AmeliaEScott/BLESoilMoistureSensors/SoilSensorHardware/nrf51x22_qfax_dcdc.kicad_pcb

## KiCad design SoilSensorHardware/nrf51x22_qfax_dcdc.kicad_pcb (2023-07-12)

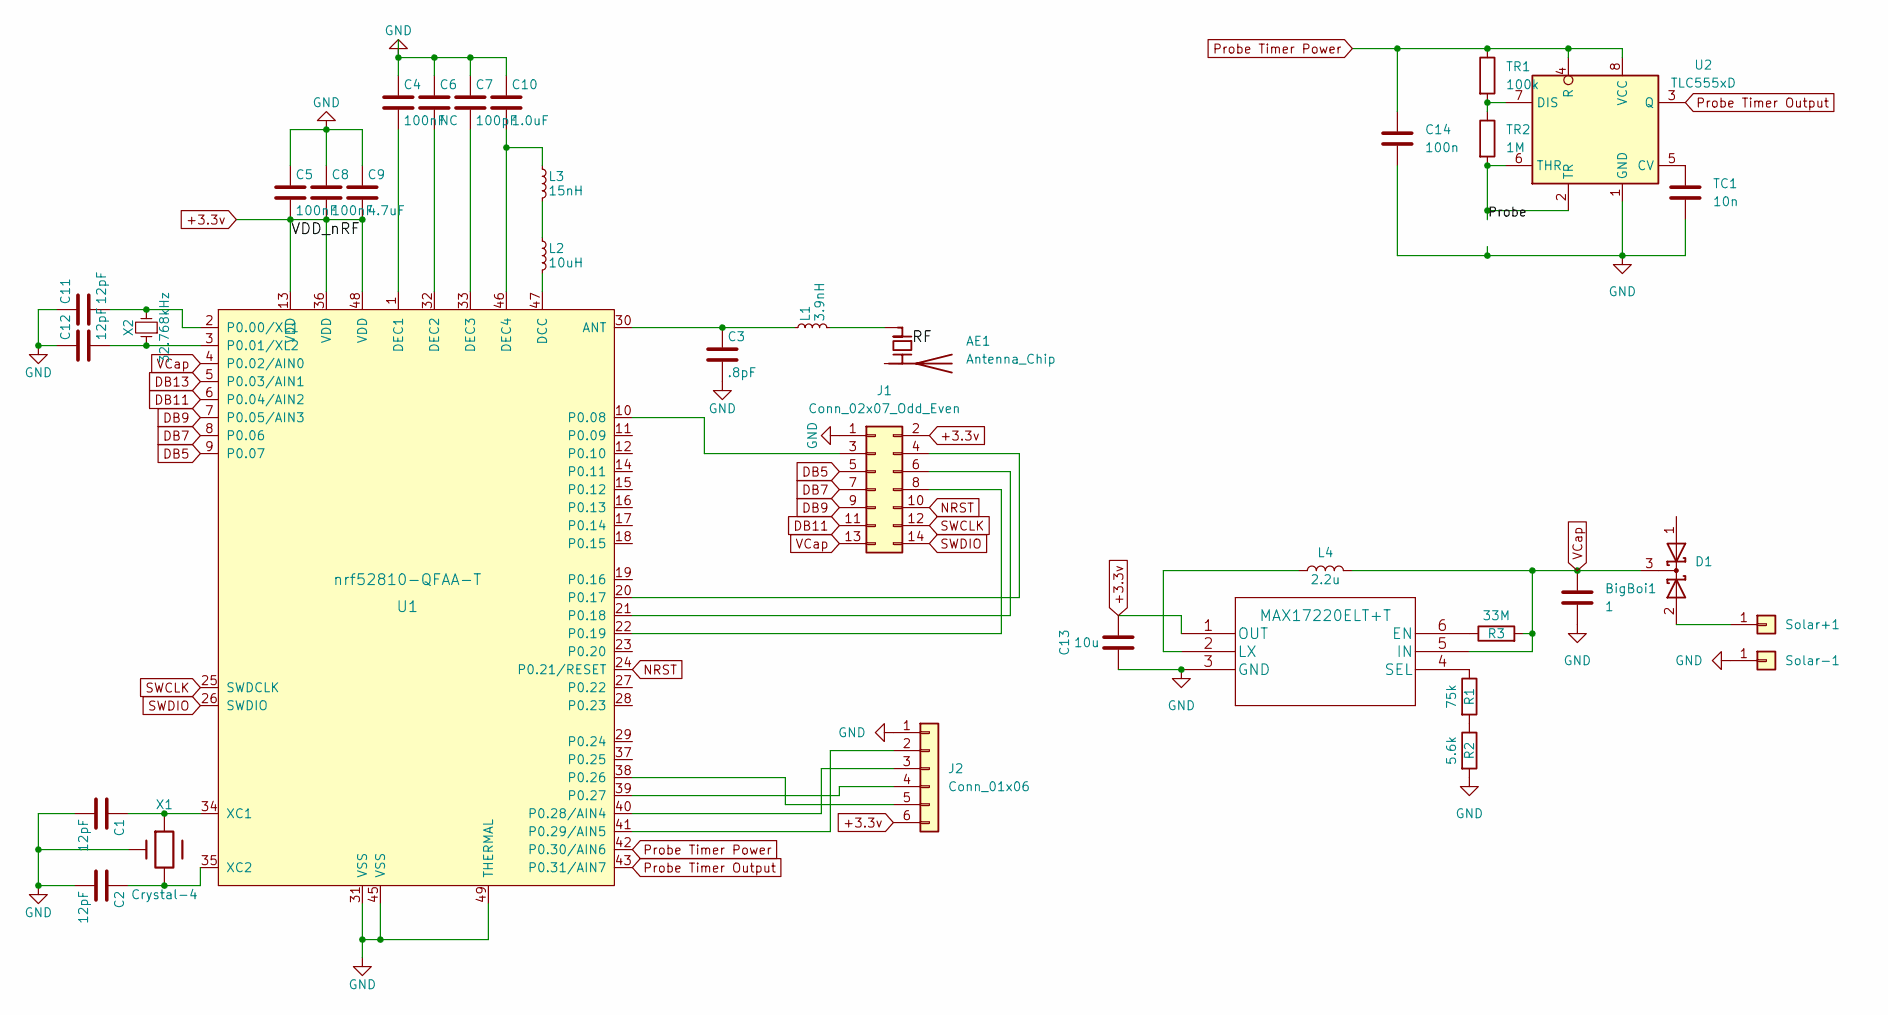
[picture p1: schematic nrf51x22_qfax_dcdc.kicad_sch]

Parts:
AE1: Antenna_Chip; R_1206_3216Metric; LCSC C504002
BigBoi1: 1; CP_Radial_D6.3mm_P2.50mm
C1, C2, C11, C12: 12pF; CAPC1005X04L; Manufacturer Part GRM1555C1H120GA01D; LCSC C1547
C3: .8pF; CAPC1005X04L; Manufacturer Part .; LCSC C172820
C4: 100nF; CAPC1005X04L; Manufacturer Part .; LCSC C1525
C5, C8: 100nF; CAPC1005X04L; Manufacturer Part CC0402KRX7R6BB104; LCSC C1525
C6: NC; C_0402_1005Metric; Manufacturer Part .
C7: 100pF; CAPC1005X04L; Manufacturer Part .; LCSC C1546
C9: 4.7uF; C_0603_1608Metric; Manufacturer Part GRM188R61C475KE11D; LCSC C19666
C10: 1.0uF; C_0603_1608Metric; Manufacturer Part .; LCSC C15849
C13: 10u; L_0603_1608Metric; LCSC C96446
C14: 100n; C_0402_1005Metric; LCSC C1525
D1: BAT54C,215; SOT-23; LCSC C37704
DCDC1: MAX17220ELT+T; MAX17220ELT&plus_T; LCSC C879657
J1: Conn_02x07_Odd_Even; PinHeader_2x07_P1.27mm_Vertical
J2: Conn_01x06; PinHeader_1x06_P2.54mm_Vertical
L1: 3.9nH; L_0402_1005Metric; LCSC C14033
L2: 10uH; INDC1608X06L; Manufacturer Part MLZ1608N100LT000; LCSC C1035
L3: 15nH; L_0402_1005Metric; Manufacturer Part MLK1005S15NJT000; LCSC C27143
L4: 2.2u; L_0805_2012Metric; LCSC C1043
R1: 75k; R_0603_1608Metric; LCSC C23242
R2: 5.6k; R_0603_1608Metric; LCSC C23189
R3: 33M; R_0603_1608Metric; LCSC C7250
Solar+1: Conn_01x01; PinHeader_1x01_P2.54mm_Vertical
Solar-1: Conn_01x01; PinHeader_1x01_P2.54mm_Vertical
TC1: 10n; C_0603_1608Metric; LCSC C57112
TR1: 100k; R_0805_2012Metric; LCSC C149504
TR2: 1M; R_0805_2012Metric; LCSC C17514
U1: nrf52810-QFAA-T; nrf51-qfax-1ep-vias; Manufacturer Part nrf52810-QFAA-T; LCSC C1558383
U2: TLC555xD; SOIC-8_3.9x4.9mm_P1.27mm; LCSC C6986
X1: Crystal-4; BT-XTAL_2016; Manufacturer Part .; LCSC C648960
X2: 32.768kHz; XTAL_3215; Manufacturer Part ABS07-32.768KHZ-9-T; LCSC C32346

Connections:
+3.3v: C5.2, C8.2, C9.2, C13.2, DCDC1.1 (OUT), J1.2, J2.6, U1.13 (VDD), U1.36 (VDD), U1.48 (VDD)
/Probe: TR2.2, U2.2 (TR), U2.6 (THR)
DB5: J1.5, U1.9 (P0.07)
DB7: J1.7, U1.8 (P0.06)
DB9: J1.9, U1.7 (P0.05/AIN3)
DB11: J1.11, U1.6 (P0.04/AIN2)
DB13: U1.5 (P0.03/AIN1)
GND: BigBoi1.2, C1.2, C2.2, C3.2, C4.1, C5.1, C6.1, C7.1, C8.1, C9.1, C10.1, C11.1, C12.1, C13.1, C14.2, DCDC1.3 (GND), J1.1, J2.1, R2.2, Solar-1.1, TC1.2, U1.31 (VSS), U1.45 (VSS), U1.49 (THERMAL), U2.1 (GND), X1.2 (4), X1.4
NC: U1.44 (NC)
NRST: J1.10, U1.24 (P0.21/RESET)
unnamed: C1.1, U1.34 (XC1), X1.1
unnamed: C2.1, U1.35 (XC2), X1.3
unnamed: C3.1, L1.1, U1.30 (ANT)
unnamed: C4.2, U1.1 (DEC1)
unnamed: C6.2, U1.32 (DEC2)
unnamed: C7.2, U1.33 (DEC3)
unnamed: C10.2, L3.1, U1.46 (DEC4)
unnamed: C11.2, U1.2 (P0.00/XL1), X2.2
unnamed: C12.2, U1.3 (P0.01/XL2), X2.1
unnamed: D1.2 (A), Solar+1.1
unnamed: DCDC1.2 (LX), L4.1
unnamed: DCDC1.4 (SEL), R1.1
unnamed: DCDC1.6 (EN), R3.1
unnamed: J1.3, U1.10 (P0.08)
unnamed: J1.4, U1.20 (P0.17)
unnamed: J1.6, U1.21 (P0.18)
unnamed: J1.8, U1.22 (P0.19)
unnamed: J2.2, U1.41 (P0.29/AIN5)
unnamed: J2.3, U1.40 (P0.28/AIN4)
unnamed: J2.4, U1.39 (P0.27)
unnamed: J2.5, U1.38 (P0.26)
unnamed: AE1.1 (FEED), L1.2
unnamed: L2.1, L3.2
unnamed: L2.2, U1.47 (DCC)
unnamed: R1.2, R2.1
unnamed: TC1.1, U2.5 (CV)
unnamed: TR1.2, TR2.1, U2.7 (DIS)
Probe Timer Output: U1.43 (P0.31/AIN7), U2.3 (Q)
Probe Timer Power: C14.1, TR1.1, U1.42 (P0.30/AIN6), U2.4 (R), U2.8 (VCC)
SWCLK: J1.12, U1.25 (SWDCLK)
SWDIO: J1.14, U1.26 (SWDIO)
VCap: BigBoi1.1, D1.3 (K), DCDC1.5 (IN), J1.13, L4.2, R3.2, U1.4 (P0.02/AIN0)

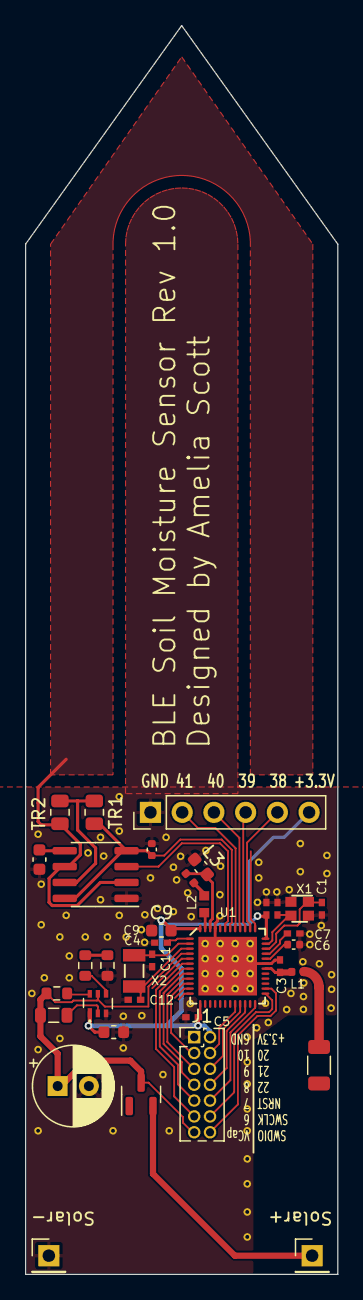
[picture p2: board nrf51x22_qfax_dcdc.kicad_pcb from above]

Board: 2 copper layers, 25.0 x 100.0 mm, 36 parts (0 on the bottom side), 40 nets.
