AmeliaEScott/BLESoilMoistureSensors/MoistureSensorBreakout/MoistureSensorBreakout.kicad_pcb

## KiCad design MoistureSensorBreakout/MoistureSensorBreakout.kicad_pcb (2023-07-01)

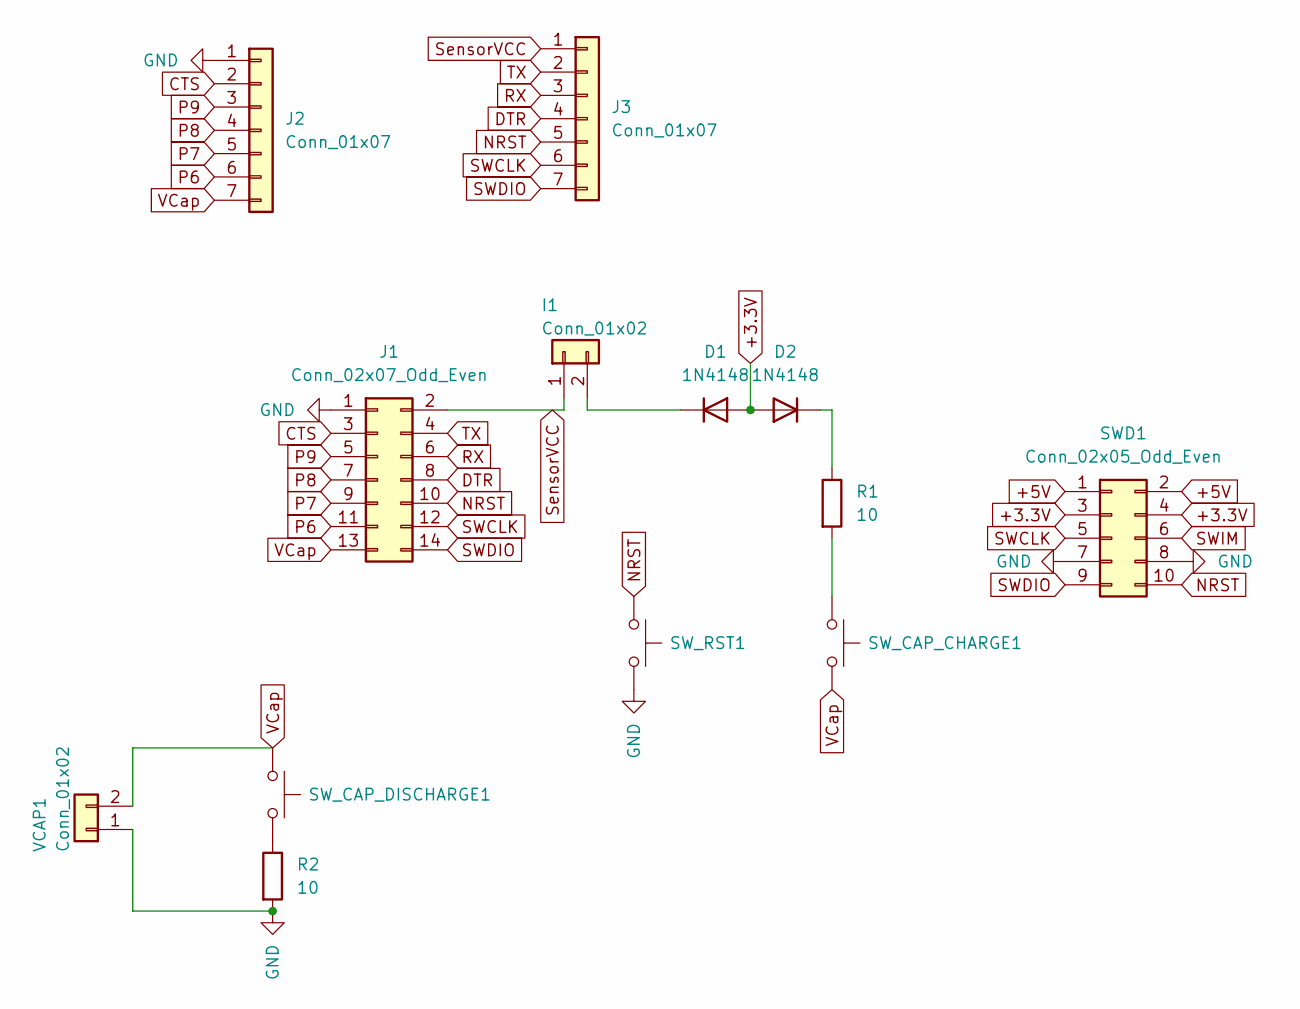
[picture p3: schematic MoistureSensorBreakout.kicad_sch]

Parts:
D1, D2: 1N4148; D_DO-35_SOD27_P7.62mm_Horizontal
I1: Conn_01x02; PinHeader_1x02_P2.54mm_Vertical
J1: Conn_02x07_Odd_Even; PinHeader_2x07_P1.27mm_Vertical
J2, J3: Conn_01x07; PinHeader_1x07_P2.54mm_Vertical
R1, R2: 10; R_Axial_DIN0207_L6.3mm_D2.5mm_P7.62mm_Horizontal
SWD1: Conn_02x05_Odd_Even; PinHeader_2x05_P2.54mm_Horizontal
SW_CAP_CHARGE1: SW_Push; SW_PUSH_6mm
SW_CAP_DISCHARGE1: SW_Push; SW_PUSH_6mm
SW_RST1: SW_Push; SW_PUSH_6mm
VCAP1: Conn_01x02; PinHeader_1x02_P2.54mm_Vertical

Connections:
+3.3V: D1.2 (A), D2.2 (A), SWD1.3, SWD1.4
+5V: SWD1.1, SWD1.2
CTS: J1.3, J2.2
DTR: J1.8, J3.4
GND: J1.1, J2.1, R2.2, SWD1.7, SWD1.8, SW_RST1.2, VCAP1.1; also elsewhere on the board
NRST: J1.10, J3.5, SWD1.10, SW_RST1.1
unnamed: D1.1 (K), I1.2
unnamed: D2.1 (K), R1.1
unnamed: R1.2, SW_CAP_CHARGE1.1
unnamed: R2.1, SW_CAP_DISCHARGE1.2
P6: J1.11, J2.6
P7: J1.9, J2.5
P8: J1.7, J2.4
P9: J1.5, J2.3
RX: J1.6, J3.3
SWCLK: J1.12, J3.6, SWD1.5
SWDIO: J1.14, J3.7, SWD1.9
SWIM: SWD1.6
SensorVCC: I1.1, J1.2, J3.1
TX: J1.4, J3.2
VCap: J1.13, J2.7, SW_CAP_CHARGE1.2, SW_CAP_DISCHARGE1.1, VCAP1.2; also elsewhere on the board

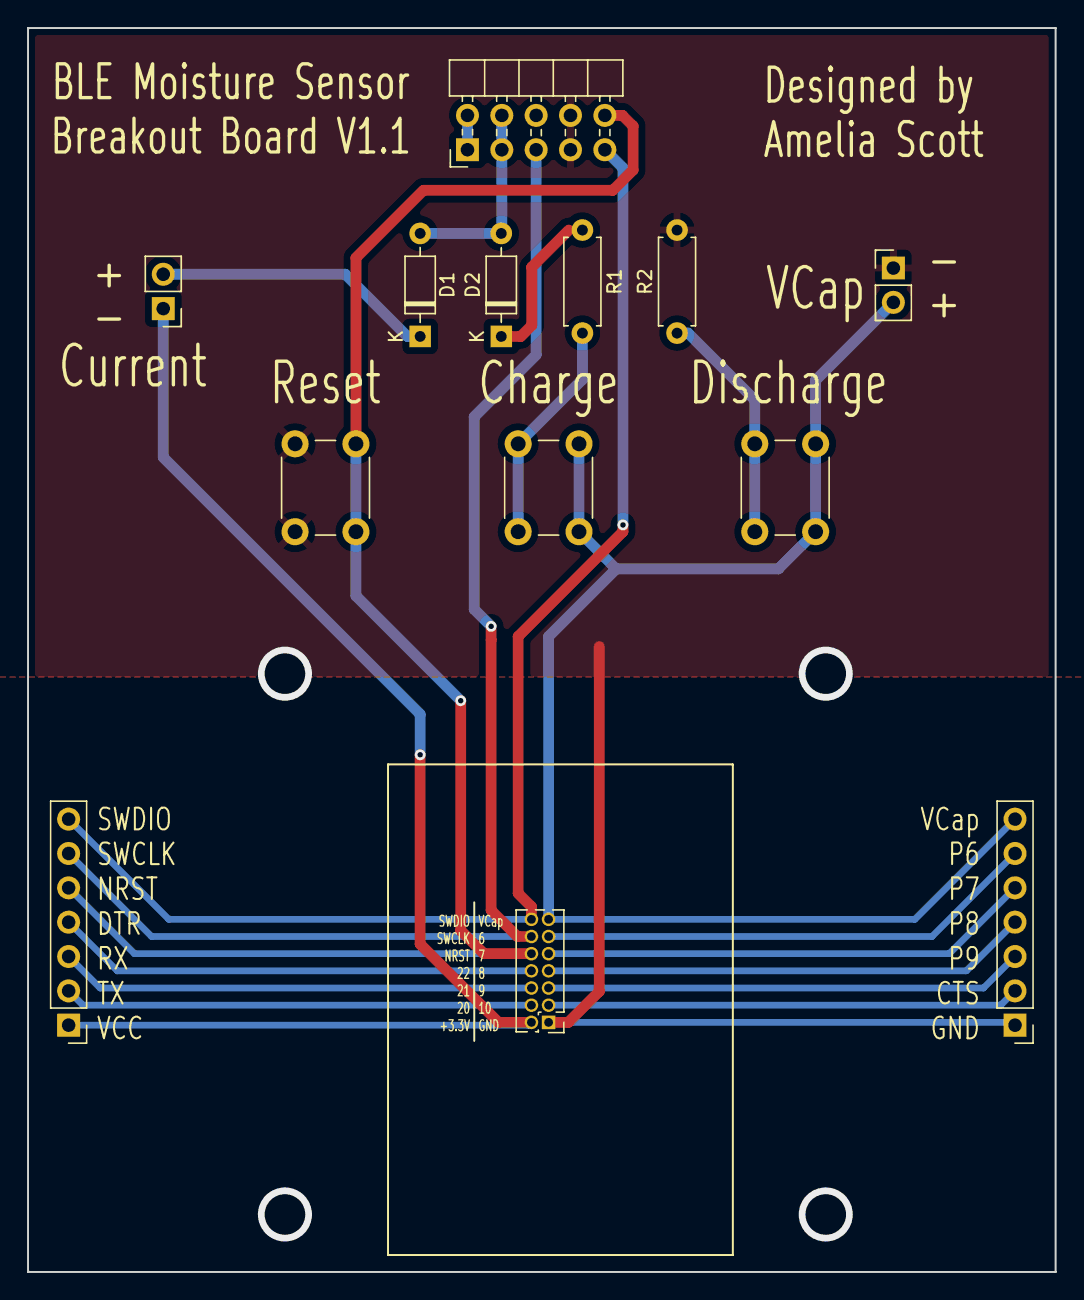
[picture p4: board MoistureSensorBreakout.kicad_pcb from above]

Board: 2 copper layers, 76.0 x 92.0 mm, 13 parts (0 on the bottom side), 20 nets.

Other parts of the board:
VCAP: Conn_01x02; PinHeader_1x02_P2.54mm_Vertical

Their connections:
GND: VCAP.1; also elsewhere on the board
VCap: VCAP.2; also elsewhere on the board
