AmeliaEScott/BLESoilMoistureSensors/TODO.txt

- Sensor
  - Use proper energy harvesting IC
  - Breakout current measuring pins
    - Maybe use one of those cut-away fuse thingies, so by default it's just shorted
