AmeliaEScott/BLESoilMoistureSensors/(commit log)

2023-06-04 Fixed (my understanding of) the external low-frequency oscillator
    [bluetooth.rs, main.rs, setup.rs]
2023-06-06 Added breakout board PCB design
    [MoistureSensorBreakout.kicad_pcb, MoistureSensorBreakout.kicad_sch]
2023-06-07 Capacitance probe timer working
2023-06-08 Fixed (I think?) timer
    [setup.rs]
2023-06-09 ADC is now working
2023-06-14 Sorted out bluetooth power management
2023-06-15 Compile-time configuration of sensor ID
2023-06-15 Stop using temperature sensor! It's used by the Softdevice
2023-06-15 Fixed interrupt priority
2023-06-16 Re-enabled temperature sensor. Will this break everything? Perhaps!
2023-06-18 Trying to manage power draw
2023-06-18 Error handling and more reliable reconnecting
    [main.rs]
2023-07-01 Notes for making a more useful breakout board
2023-07-01 New version of breakout / programming board
    [MoistureSensorBreakout-B_Cu.gbl, MoistureSensorBreakout-B_Mask.gbs, MoistureSensorBreakout-B_Paste.gbp, MoistureSensorBreakout-B_Silkscreen.gbo, MoistureSensorBreakout-Edge_Cuts.gm1, MoistureSensorBreakout-F_Cu.gtl, MoistureSensorBreakout-F_Mask.gts, MoistureSensorBreakout-F_Paste.gtp]
2023-07-07 Enable reset pin
2023-07-07 Floating reset pin = bad idea
2023-07-08 Attempting to address errata
    [sensor_periph.rs]
2023-07-12 Moved power trace from under HF crystal
    [nrf51x22_qfax_dcdc.kicad_pcb]
2023-07-20 Friendship ended with monotonics. Now low power usage is my best friend
2024-10-03 I don't remember what's in these changes. Just committing so I have it in case it ends up being important
